Matheus3007/pcb-lab/boards/README.md

# Boards

| Board | Purpose | Status |
|---|---|---|
| `_template` | starting point, copy it | n/a |
| `pipeline-demo` | Phase 0 reference board: proves the pipeline end to end | done: all gates passed, JLC preview verified (not ordered) |
| `rebot-esc` | Rebot plug-in AM32 drive-ESC module (see docs/projects/battlebot.md) | parked after gate 2 (not approved): replaced by an off-the-shelf 4-in-1 |
| `rebot-ctrl` | Rebot mini controller: STM32G431 + IMU, CRSF in, DShot to a 4-in-1 ESC (see docs/projects/battlebot.md) | gate 3 packet + fab files ready (30 × 28 mm), not ordered |
| `rebot-ctrl-v2` | Smaller rebot-ctrl: STM32G431 in UFQFPN-32, signals on F + In2 between GND planes (25 × 25 mm) | gate 3 packet + fab files ready, not ordered |
