Matheus3007/pcb-lab/boards/rebot-ctrl/build/reports/summary.md

# rebot-ctrl — checks PASS

0 errors · 0 warnings · 47 waived  
board 30.05 × 28.05 mm · 58 footprints · 519 track segments · 118 vias · 605.28 mm copper

## circuit
- ✓ `circuit/assertion` Buck Vin: spike budget vs LMR36506 65 V: 40 V in [0, 58.5]
- ✓ `circuit/assertion` Buck output (RFBT 100k / RFBB 22k): 5.545 V in [5.3, 5.8]
- ✓ `circuit/assertion` +5V rail after the OR diode (receiver supply): 5.195 V in [4.75, 5.5]
- ✓ `circuit/assertion` +5V vs XC6206 6.0 V max input: 5.545 V in [0, 6]
- ✓ `circuit/assertion` XC6206 headroom (dropout ~0.25 V @ 100 mA): 1.895 V in [0.4, 3]
- … 7 more `circuit/assertionok`

## schematic
- ✓ `schematic/pins_match` all 209 symbol pins match parts.yaml
- ✓ `schematic/netlist_match` KiCad's netlist of the schematic equals circuit.py (43 nets)

## erc
- ! `erc/pin_to_pin` Pins of type Bidirectional and Power output are connected: Symbol U4 Pin 2 [SDX, Bidirectional, Line]; Symbol #FLG02 Pin 1 [Power output, Line] _(waived: LSM6DSV32X DS13511 table 2: SDx must be tied to VDD_IO or GND when the analog hub/Qvar is unused; tied to GND)_
- ! `erc/pin_to_pin` Pins of type Bidirectional and Power output are connected: Symbol U5 Pin 3 [~{WP}/IO_{2}, Bidirectional, Line]; Symbol U3 Pin 2 [VO, Power output, Line] _(waived: W25Q128JV: /WP tied high for standard (non-quad) SPI, as the datasheet requires; IO2 is never driven)_
- ! `erc/pin_to_pin` Pins of type Bidirectional and Power output are connected: Symbol U5 Pin 7 [~{HOLD}/~{RESET}/IO_{3}, Bidirectional, Line]; Symbol U3 Pin 2 [VO, Power output, Line] _(waived: W25Q128JV: /HOLD tied high for standard (non-quad) SPI, as the datasheet requires; IO3 is never driven)_

## drc
- ! `drc/silk_edge_clearance` Silkscreen clipped by board edge (board setup constraints silk clearance 0.1500 mm; actual 0.0000 mm): Polygon on Edge.Cuts; Segment of J3 on F.Silkscreen _(waived: USB-C footprint silk outline intentionally reaches the board edge (connector overhang marker, as in pipeline-demo); clipped by fab)_
- ! `drc/silk_edge_clearance` Silkscreen clipped by board edge (board setup constraints silk clearance 0.1500 mm; actual 0.1400 mm): Polygon on Edge.Cuts; Segment of J3 on F.Silkscreen _(waived: USB-C footprint silk outline intentionally reaches the board edge (connector overhang marker, as in pipeline-demo); clipped by fab)_

## parity
- ✓ `parity/ok` board matches the schematic (KiCad schematic parity)

## placement
- ✓ `placement/near` C10 -> U1 pad 23: 3.87 mm (max 4.4) — MCU VDD (pin 23) decoupling
- ✓ `placement/near` C11 -> U1 pad 35: 2.11 mm (max 2.6) — MCU VDD (pin 35) decoupling
- ✓ `placement/near` C12 -> U1 pad 48: 1.58 mm (max 2.1) — MCU VDD (pin 48) decoupling
- ✓ `placement/near` C15 -> U1 pad 21: 2.82 mm (max 3.3) — VDDA HF decoupling
- ✓ `placement/near` C14 -> U1 pad 21: 1.78 mm (max 2.3) — VDDA bulk
- ✓ `placement/on_edge` J1 courtyard -0.18 mm from top edge — ESC cable plugs in from the top edge
- ✓ `placement/on_edge` J3 courtyard -0.52 mm from top edge — USB-C mouth at the top edge (reachable with the lid off)
- ✓ `placement/on_edge` J2 courtyard -0.17 mm from left edge — receiver cable comes from the robot left side
- … 18 more `placement/nearok`

## parts
- · `parts/tiers` 24 unique parts: basic 15, preferred 1, extended 8 (extended: C160407 SM08B-SRSS-TB(LF)(SN), C189895 SM04B-GHS-TB(LF)(SN), C165948 TYPE-C-31-M-12, C2870127 LMR36506RRPER, C167761 FNR3015S220MT, C529356 STM32G431CBU6, C22461202 LSM6DSV32XTR, C190862 W25Q128JVPIQ)

## current
- ✓ `current/width` GND: min track 0.3 mm vs 0.115 mm needed for 0.5 A (IPC-2221, ΔT 10 °C, 1.0 oz)
- ✓ `current/width` VBAT: min track 0.4 mm vs 0.115 mm needed for 0.5 A (IPC-2221, ΔT 10 °C, 1.0 oz)
- ✓ `current/width` +5V: min track 0.4 mm vs 0.115 mm needed for 0.5 A (IPC-2221, ΔT 10 °C, 1.0 oz)
- ✓ `current/width` VBUS: min track 0.4 mm vs 0.115 mm needed for 0.5 A (IPC-2221, ΔT 10 °C, 1.0 oz)
- ✓ `current/width` BUCK_SW: min track 0.24 mm vs 0.115 mm needed for 0.5 A (IPC-2221, ΔT 10 °C, 1.0 oz)
- … 2 more `current/widthok`

## routing
- ! `routing/jog` 3V3 on F.Cu: 0.74 mm sideways step at (10.24, 17.36) (board coords, +Y down); straighten it (REROUTE=1, placement, or a scripted track) _(waived: 3V3 distribution, DC and decoupled at every pin; sub-mm steps around the QFN pins and fan-out vias)_
- ! `routing/jog` 3V3 on F.Cu: 0.28 mm sideways step at (10.76, 16.84) (board coords, +Y down); straighten it (REROUTE=1, placement, or a scripted track) _(waived: 3V3 distribution, DC and decoupled at every pin; sub-mm steps around the QFN pins and fan-out vias)_
- ! `routing/jog` 3V3 on F.Cu: 0.35 mm sideways step at (18.77, 16.82) (board coords, +Y down); straighten it (REROUTE=1, placement, or a scripted track) _(waived: 3V3 distribution, DC and decoupled at every pin; sub-mm steps around the QFN pins and fan-out vias)_
- ! `routing/jog` BUCK_FB on F.Cu: 1.33 mm sideways step at (3.82, 22.10) (board coords, +Y down); straighten it (REROUTE=1, placement, or a scripted track) _(waived: buck feedback node leaves U2 pin 8 around the GND pad's top exit to the divider; short, low-impedance divider node, no switching current)_
- ! `routing/jog` BUCK_SW on F.Cu: 0.20 mm sideways step at (5.11, 25.66) (board coords, +Y down); straighten it (REROUTE=1, placement, or a scripted track) _(waived: 0.2 mm step where the SW node meets the bootstrap cap C3; adds no measurable loop area (SW trace is 2 mm long))_
- · `routing/stats` 320 bends total; per net: +5V 11, 3V3 51, BOOT0 13, BUCK_BOOT 3, BUCK_FB 7, BUCK_SW 14, BUCK_VCC 7, CC1 3, CC2 3, CRSF_IN 3, CRSF_OUT 3, CRSF_RX 4, CRSF_TX 8, CURR_ADC 9, DSHOT1 5, DSHOT2 3, DSHOT3 5, DSHOT4 7, ESC_CURR 1, ESC_TLM 1, FLASH_CS 3, GND 7, IMU_CS 13, IMU_INT1 7, LED 7, LED_A 1, M1 6, M2 2, M3 4, M4 1, NRST 12, SPI_MISO 9, SPI_MOSI 12, SPI_SCK 11, SWCLK 6, SWDIO 7, TLM_RX 5, USB_DM 5, USB_DP 5, V5_BUCK 7, VBAT 14, VBAT_ADC 12, VBUS 3
- … 37 more `routing/jogwarningw`

## layout
- · `layout/return_path` BOOT0: 0.28 mm of track has no GND under it on the reference layer (worst 0.28 mm on B.Cu over a gap in In2.Cu at (13.41, 18.26)); the return current detours around the gap (loop area, crosstalk)
- ✓ `layout/finger` no unstitched dead-end GND tongues longer than 8.0 mm
- ✓ `layout/loop` buck HF input loop (C2): 2.12 mm² enclosed by C2.1 → U2.4 → U2.9 → C2.2 (max 3.0 mm²)
- ✓ `layout/loop` buck HF input loop (C2): U2.9 and C2.2 (GND) are not joined by copper on F.Cu; nearest GND vias 1.20 / 0.67 mm from them (max 1.5 mm, so the return drops straight into the plane)
- ✓ `layout/loop` buck bulk input loop (C1): 3.86 mm² enclosed by C1.1 → U2.4 → U2.9 → C1.2 (max 6.0 mm²)
- ✓ `layout/pair` USB_DP/USB_DM: lengths 16.15/11.92 mm, skew 4.23 mm (max 5.0)
