Matheus3007/pcb-lab/boards/rebot-ctrl-v2/build/fab/rebot-ctrl-v2-bom.csv

Comment | Designator | Footprint | LCSC Part #
JST-SH 8P (ESC) | J1 | JST_SH_SM08B-SRSS-TB_1x08-1MP_P1.00mm_Horizontal | C160407
JST-GH 4P (receiver) | J2 | JST_GH_SM04B-GHS-TB_1x04-1MP_P1.25mm_Horizontal | C189895
100 | R1,R2,R9,R10,R11,R12 | R_0402_1005Metric | C25076
USB-C 16P | J3 | USB_C_Receptacle_HRO_TYPE-C-31-M-12 | C165948
5.1k | R3,R4 | R_0402_1005Metric | C25905
B5819WS 40V 1A | D1,D2 | D_SOD-323 | C64886
LMR36506 buck | U2 | VQFN-HR-9_2x2mm_TI_RPE0009A | C2870127
22uH 3015 | L1 | L_Changjiang_FNR3015S | C167761
2.2uF | C1 | C_0805_2012Metric | C377773
100nF | C2,C3,C10,C11,C15,C16,C17,C18,C19,C20,C21 | C_0402_1005Metric | C307331
1uF | C4,C7,C8,C14 | C_0402_1005Metric | C52923
22uF | C5 | C_0805_2012Metric | C45783
100k | R5,R13,R15 | R_0402_1005Metric | C25741
22k | R6 | R_0402_1005Metric | C25768
XC6206 3.3V | U3 | SOT-23-3 | C5446
4.7uF | C6,C9,C13 | C_0402_1005Metric | C23733
STM32G431KBU6 | U1 | UFQFPN-32-1EP_5x5mm_P0.5mm_EP3.5x3.5mm | C529358
10k | R7,R14,R16,R18,R19 | R_0402_1005Metric | C25744
1k | R8,R17 | R_0402_1005Metric | C11702
red | D3 | LED_0603_1608Metric | C2286
LSM6DSV32X | U4 | LGA-14_3x2.5mm_P0.5mm_LayoutBorder3x4y | C22461202
GD25Q128E 16MB | U5 | WSON-8-1EP_6x5mm_P1.27mm_EP3.4x4.3mm | C24733358
