Matheus3007/pcb-lab/boards/rebot-ctrl-v2/build/review/gate-3.md

# rebot-ctrl-v2: review gate 3
_generated 2026-10-25 23:35 · checks PASS_

## Renders
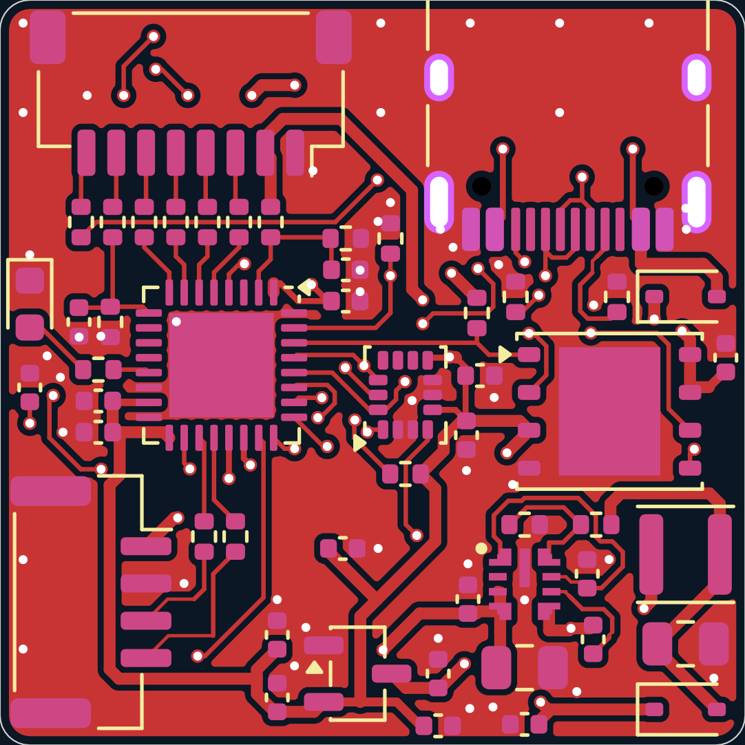
[picture p1: boards/rebot-ctrl-v2/build/renders/top.png]
top

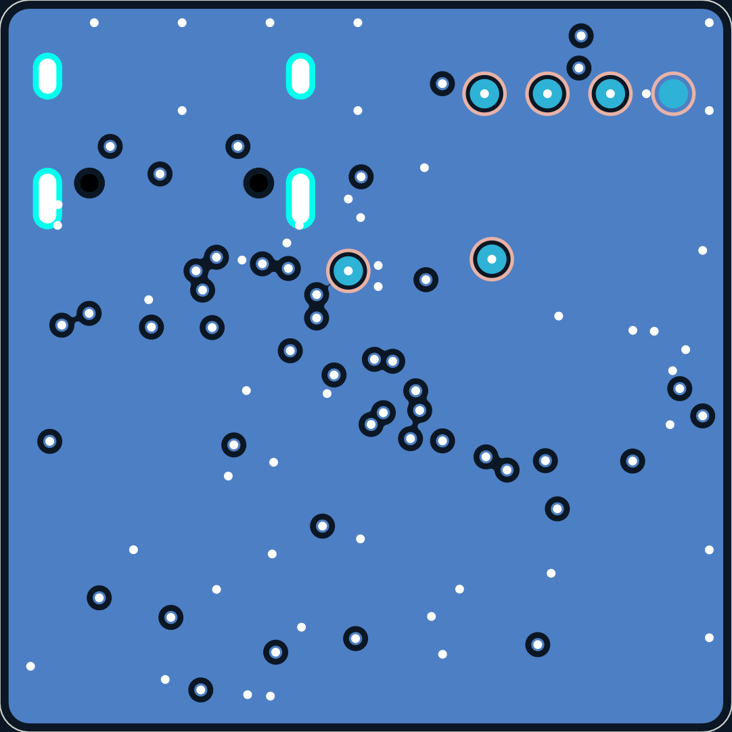
[picture p2: boards/rebot-ctrl-v2/build/renders/bottom.png]
bottom

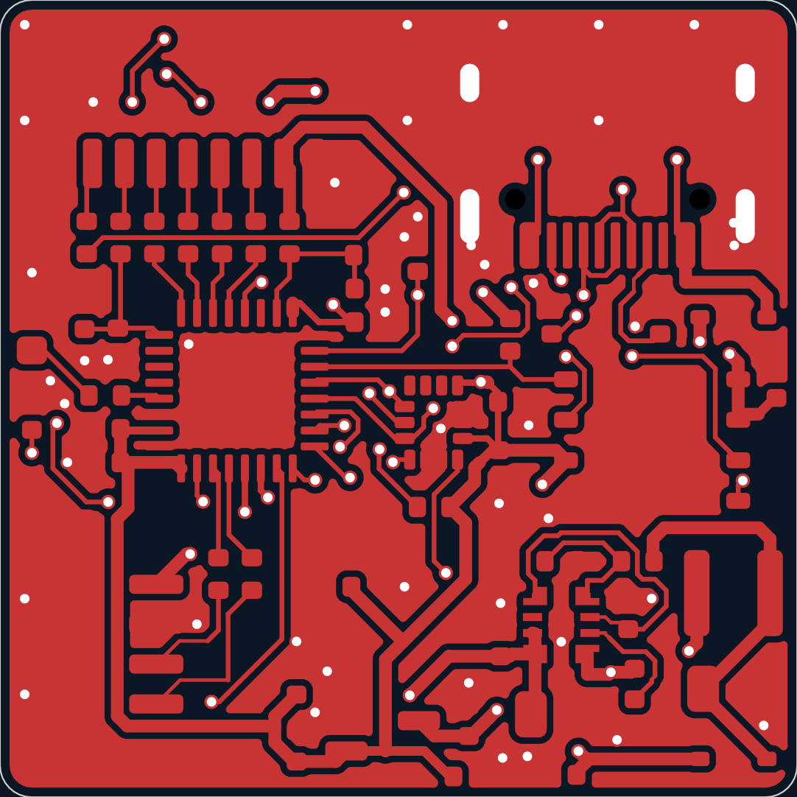
[picture p3: boards/rebot-ctrl-v2/build/renders/copper_top.png]
copper top

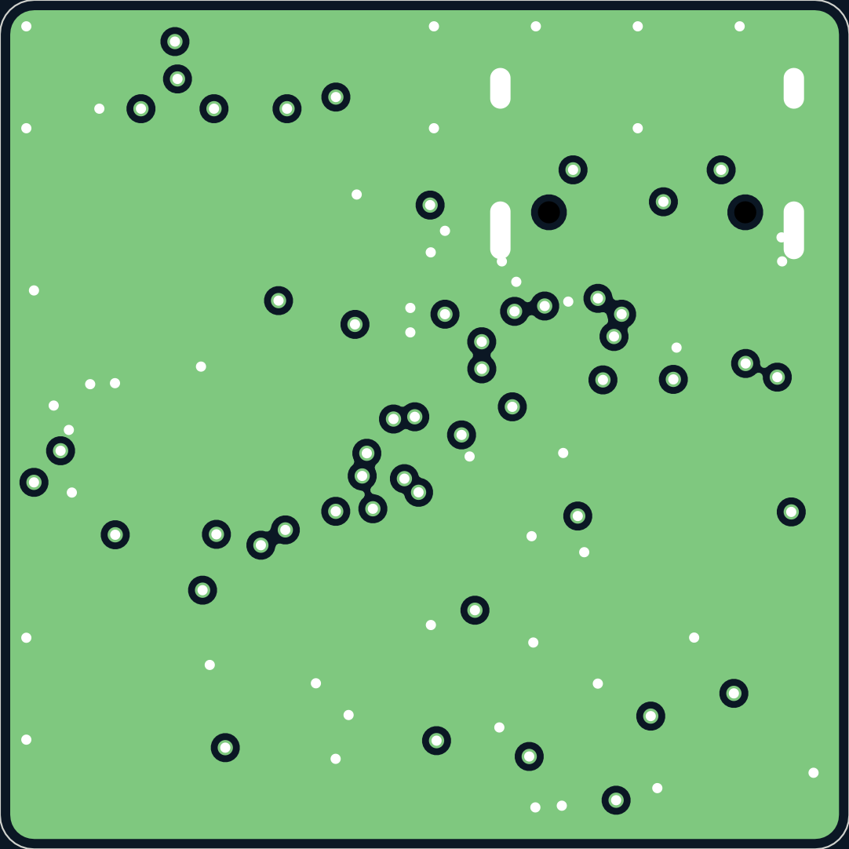
[picture p4: boards/rebot-ctrl-v2/build/renders/copper_in1.png]
copper in1

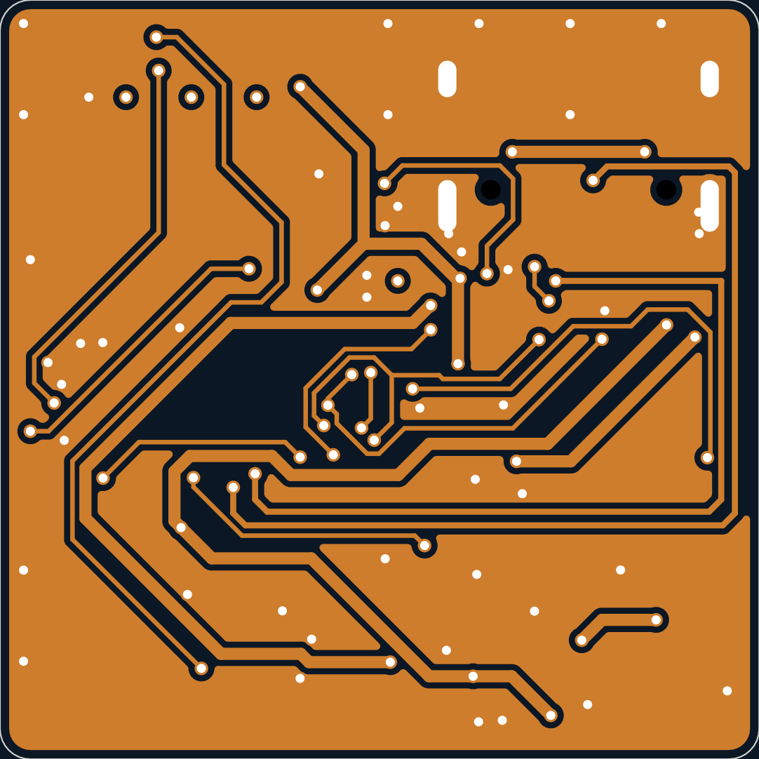
[picture p5: boards/rebot-ctrl-v2/build/renders/copper_in2.png]
copper in2

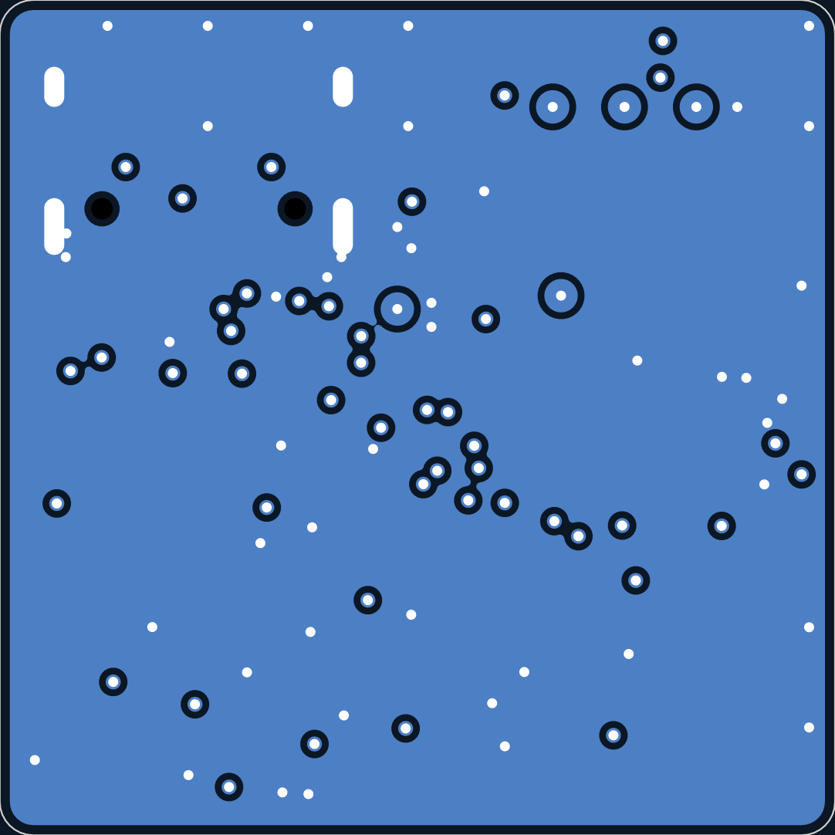
[picture p6: boards/rebot-ctrl-v2/build/renders/copper_bottom.png]
copper bottom

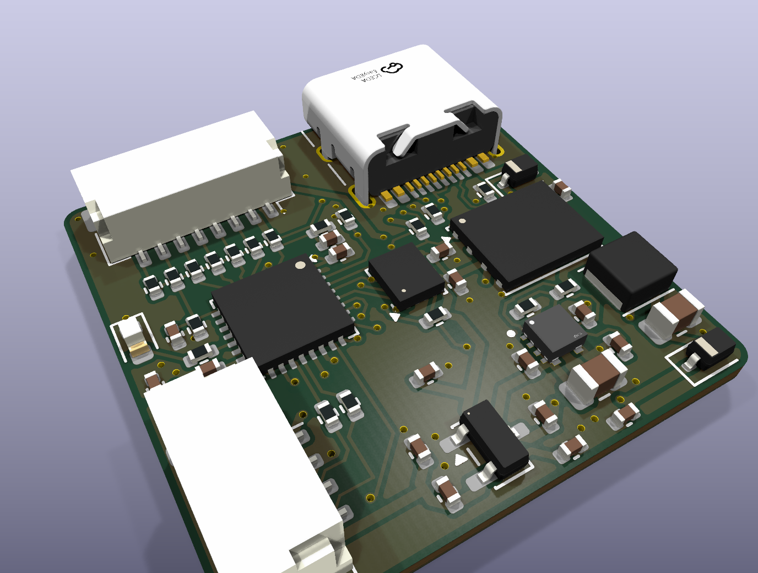
[picture p7: boards/rebot-ctrl-v2/build/renders/3d_iso.png]
3d iso


## Fab files (build/fab/)
- cpl_corrections.json
- rebot-ctrl-v2-bom.csv
- rebot-ctrl-v2-cpl.csv
- rebot-ctrl-v2-gerbers.zip
- rebot-ctrl-v2.kicad_pcb

## CPL rotation corrections applied (UNVERIFIED until you check JLC's preview)
- J2 `JST_GH_SM04B-GHS-TB_1x04-1MP_P1.25mm_Horizontal`: +0° (rule `^JST_GH_SM`, confirmed)
- J3 `USB_C_Receptacle_HRO_TYPE-C-31-M-12`: +0° (rule `^USB_C_Receptacle_HRO_TYPE-C-31-M-12`, confirmed)
- U1 `UFQFPN-32-1EP_5x5mm_P0.5mm_EP3.5x3.5mm`: -90° (rule `^UFQFPN-32-1EP_5x5mm`, confirmed)
- U3 `SOT-23-3`: +180° (rule `^SOT-23`, confirmed)
- U5 `WSON-8-1EP_6x5mm_P1.27mm_EP3.4x4.3mm`: +0° (rule `lcsc:C24733358`, confirmed)

Parts cost per board ≈ $18.46 + extended-part fees (8 unique extended)

## Before paying
1. Upload the gerber zip; inspect JLC's Gerber viewer (outline, cutouts, drills).
2. Upload BOM + CPL; check EVERY part's rotation/polarity in JLC's placement preview.
3. Record corrections in lib/jlc_rotations.csv (top of file), rebuild, re-upload.
4. After ordering: `git tag <board>/vX.Y` and note the order number in spec.md.
