Matheus3007/pcb-lab/boards/rebot-ctrl-v2/build/fab/rebot-ctrl-v2.kicad_pcb

## KiCad design boards/rebot-ctrl-v2/build/fab/rebot-ctrl-v2.kicad_pcb (2026-10-26)

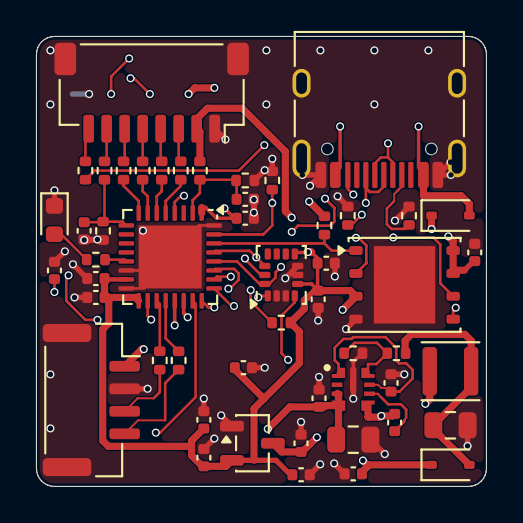
[picture p25: board rebot-ctrl-v2.kicad_pcb from above]

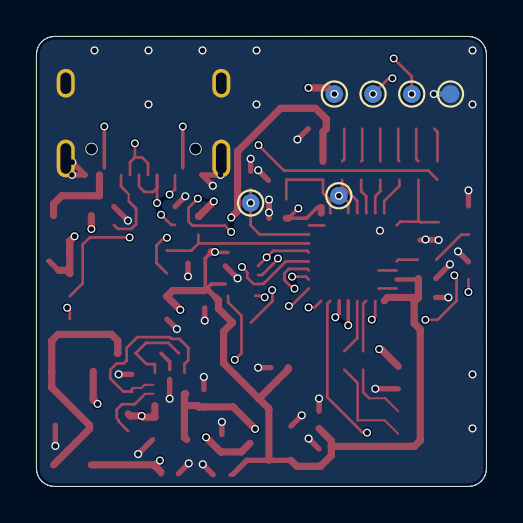
[picture p26: board rebot-ctrl-v2.kicad_pcb from below]

Board: 4 copper layers, 25.0 x 25.0 mm, 57 parts (6 on the bottom side), 43 nets.

Parts:
C1: 2.2uF; C_0805_2012Metric
C2, C3, C10, C11, C15, C16, C17, C18, C19, C20, C21: 100nF; C_0402_1005Metric
C4, C7, C8, C14: 1uF; C_0402_1005Metric
C5: 22uF; C_0805_2012Metric
C6, C9, C13: 4.7uF; C_0402_1005Metric
D1, D2: B5819WS 40V 1A; D_SOD-323
D3: red; LED_0603_1608Metric
J1: JST-SH 8P (ESC); JST_SH_SM08B-SRSS-TB_1x08-1MP_P1.00mm_Horizontal
J2: JST-GH 4P (receiver); JST_GH_SM04B-GHS-TB_1x04-1MP_P1.25mm_Horizontal
J3: USB-C 16P; USB_C_Receptacle_HRO_TYPE-C-31-M-12
L1: 22uH 3015; L_Changjiang_FNR3015S
R1, R2, R9, R10, R11, R12: 100; R_0402_1005Metric
R3, R4: 5.1k; R_0402_1005Metric
R5, R13, R15: 100k; R_0402_1005Metric
R6: 22k; R_0402_1005Metric
R7, R14, R16, R18, R19: 10k; R_0402_1005Metric
R8, R17: 1k; R_0402_1005Metric
TP1, TP2, TP3, TP4, TP5, TP6: pad; TestPoint_Pad_D1.0mm
U1: STM32G431KBU6; UFQFPN-32-1EP_5x5mm_P0.5mm_EP3.5x3.5mm
U2: LMR36506 buck; VQFN-HR-9_2x2mm_TI_RPE0009A
U3: XC6206 3.3V; SOT-23-3
U4: LSM6DSV32X; LGA-14_3x2.5mm_P0.5mm_LayoutBorder3x4y
U5: GD25Q128E 16MB; WSON-8-1EP_6x5mm_P1.27mm_EP3.4x4.3mm

Connections:
3V3: C8.1, C9.1, C10.1, C11.1, C13.1, C14.1, C15.1, C19.1, C20.1, C21.1, R18.2, R19.2, TP1.1, U1.1, U1.15, U1.17, U3.2, U4.5, U4.8, U5.3, U5.7, U5.8
+5V: C6.1, C7.1, D1.1, D2.1, J2.1, U3.3
BOOT0: R7.1, TP6.1, U1.31
BUCK_BOOT: C3.1, U2.6
BUCK_FB: R5.2, R6.1, U2.8
BUCK_SW: C3.2, L1.1, U2.5
BUCK_VCC: C4.1, U2.1, U2.7
CC1: J3.A5, R3.1
CC2: J3.B5, R4.1
CRSF_IN: J2.3, R1.1
CRSF_OUT: J2.4, R2.1
CRSF_RX: R1.2, U1.19
CRSF_TX: R2.2, U1.20
CURR_ADC: C17.1, R13.2, R14.1, U1.9
DSHOT1: R9.2, U1.5
DSHOT2: R10.2, U1.6
DSHOT3: R11.2, U1.7
DSHOT4: R12.2, U1.8
ESC_CURR: J1.7, R13.1
ESC_TLM: J1.8, R17.1
FLASH_CS: R19.1, U1.30, U5.1
GND: C1.2, C2.2, C4.2, C5.2, C6.2, C7.2, C8.2, C9.2, C10.2, C11.2, C13.2, C14.2, C15.2, C16.2, C17.2, C18.2, C19.2, C20.2, C21.2, D3.1, J1.1, J1.MP, J2.2, J2.MP, J3.A1, J3.A12, J3.B1, J3.B12, J3.SH, R3.2, R4.2, R6.2, R7.2, R14.2, R16.2, TP2.1, U1.14, U1.16, U1.32, U1.33, U2.9, U3.1, U4.2, U4.3, U4.6, U4.7, U5.4, U5.9
IMU_CS: R18.1, U1.29, U4.12
IMU_INT1: U1.18, U4.4
LED: R8.1, U1.13
LED_A: D3.2, R8.2
M1: J1.3, R9.1
M2: J1.4, R10.1
M3: J1.5, R11.1
M4: J1.6, R12.1
NRST: C16.1, TP5.1, U1.4
SPI_MISO: U1.27, U4.1, U5.2
SPI_MOSI: U1.28, U4.14, U5.5
SPI_SCK: U1.26, U4.13, U5.6
SWCLK: TP4.1, U1.24
SWDIO: TP3.1, U1.23
TLM_RX: R17.2, U1.25
USB_DM: J3.A7, J3.B7, U1.21
USB_DP: J3.A6, J3.B6, U1.22
V5_BUCK: C5.1, D1.2, L1.2, R5.1
VBAT: C1.1, C2.1, J1.2, R15.1, U2.3, U2.4
VBAT_ADC: C18.1, R15.2, R16.1, U1.2
VBUS: D2.2, J3.A4, J3.A9, J3.B4, J3.B9
