Matheus3007/pcb-lab/(commit log)

2026-10-11 Scaffold pcb-lab: code-first PCB pipeline docs, board template, toolchain decision
2026-10-11 Phase 0: working code-first PCB pipeline + pipeline-demo board
    Replace atopile (CLI end-of-life, part picking now needs sign-in, APIs down) with
    plain-Python circuits (decision 0002). Pipeline: circuit.py -> pcbnew board
    generation -> Freerouting -> GND stitching -> DRC + custom checks -> renders ->
    JLC gerbers/BOM/CPL, review dashboard + gate packets, semantic diff.
    pipeline-demo passes all checks (0 errors, 0 warnings, 2 waived).
2026-10-11 Deterministic builds: route lock for Freerouting, sorted board dump
    Freerouting is not deterministic (unseeded randomness even single-threaded), so its
    SES output is committed as route.lock.ses keyed by a canonical fingerprint of the DSN
    input. Same sources now produce a byte-identical board.json; REROUTE=1 forces a new
    route. Also disables Freerouting analytics.
2026-10-11 Write LF line endings from KiCad-side jobs
2026-10-11 Agent knowledge: hard-won lessons in CLAUDE.md, 5 project skills, part/footprint research commands
    - CLAUDE.md: environment, tooling, data-source and geometry lessons from Phase 0
    - .claude/skills: new-board, add-part, board-iteration (with DRC playbook), review-gate, jlc-order
    - make part LCSC=...: JLC data, datasheet via JLC file endpoint, pin-table pages as text+PNG,
    KiCad footprint candidates
    - make footprint FP=...: pad table, body/courtyard extents, facing hint, 3D model check, PNG
    - lib/basic_passives.yaml: catalog-verified JLC Basic passives
2026-10-11 Add make open: view a generated board in KiCad's PCB editor
2026-10-11 KiCad 10.0.7: version-independent route-lock fingerprint, solid shield-pad pour connection
    KiCad auto-updated 10.0.5 -> 10.0.7; the DSN parser header (host_version) was part of the
    route-lock fingerprint, forcing a reroute that exposed starved thermals on the USB-C
    shield pads. Fingerprint now ignores the parser header; parts.yaml can set per-pad
    zone_connection (USB-C SH pads: full). pipeline-demo rerouted once and passes again.
2026-10-11 JLC preview fixes: shared bottom-left origin, no drill maps, confirmed rotation table
    From the first JLC preview of pipeline-demo:
    - gerbers/drill used page-absolute coords while the CPL used the aux origin -> 'component may
    be offset' prompt. All three now use the aux origin at the outline's bottom-left.
    - drill maps were shipped in the zip and showed up as an extra layer; removed.
    - community rotation hints were wrong for HRO TYPE-C-31-M-12 (+180 put the leads at the edge)
    and SOT-23 (-90 put legs off the pads). New lib/jlc_rotations_confirmed.csv takes precedence.
2026-10-11 JLC CPL: 1.575 mm origin offset for HRO TYPE-C-31-M-12 (preview 2 showed overhang)
2026-10-11 JLC CPL: confirm HRO USB-C offset; SOT-23 needs 180 deg (preview showed pin 1 diagonally opposite)
2026-10-11 Routing quality: no unneeded bends
    - routeq: jog detector + bend stats; routing/jog check (warning) and routing/stats
    - best-of-N autorouting with seeded DSN permutations (reproducible variety) scored on
    jogs, vias, bends and length; all attempts recorded in route.lock.json
    - kijobs/straighten.py: cuts jogs like KiCad's optimizer, clearance-checked
    - parts/extended check: plain Extended parts need extended_reason
    - CLAUDE.md + skills: no-unneeded-bends rule, Basic > Preferred > Extended priority,
    corrected Freerouting determinism lesson
    pipeline-demo rerouted: 0 jogs (was 6), 28 bends (was 40), 75 mm copper (was 102 mm), no
    loop around J1. Checks PASS.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
2026-10-11 Generated KiCad schematic from circuit.py: ERC, pin cross-check, parity, editable layout
    circuit.py stays the only source of connectivity. Every build now also writes a one-sheet
    KiCad 10 schematic (stock symbols, global net label on every pin, NC flags, parts framed by
    `with c.block(...)`, PWR_FLAGs from `c.power_flag(...)`) and checks it four ways:
    - schematic/pin_name: KiCad symbol pin names vs parts.yaml names per pad (catches clone pinouts)
    - schematic/netlist_match: KiCad's own netlist of the drawing == circuit.py, pad for pad
    - erc/*: KiCad ERC with pin electrical types
    - parity/*: DRC --schematic-parity, board == schematic
    Layout is human-editable: move things in KiCad (make sch-ope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
2026-10-11 battlebot: record Rebot facts, v1/v2 scope and rear-wall board location
    Robot specs (6S LiHV 26.1 V, wye-wound motors, 64 g electronics budget), the RX
    brownout hypothesis (BEC rated 7-26 V), connector and pigtail rules, v1 = controller +
    onboard drive ESCs with v2 weapon ESC, R$600 per order, and the board location measured
    from RebotAssemblyV3.STEP: ~78x30 mm standing against the inner rear wall.
2026-10-11 battlebot: carrier board + plug-in AM32 drive-ESC modules
    All wiring ends on a vertical carrier; drive ESCs are screw-retained plug-in modules
    (~15x22 mm) so a dead ESC swaps in about a minute without soldering. Modules sized
    for 20-30 A peak phase current, since the measured 2.5 A drive draw is battery-side.
2026-10-11 battlebot: drive-ESC module research, OpenESC-20x20 as reference
    Stock AM32 target OPENESC_20_F421 (AT32F421 + NSG2065Q) runs unmodified if the pin
    mapping is kept; MOSFETs move from 30 V to 60 V for 6S LiHV. Candidate JLC parts,
    CERN-OHL-S licence note, and the open header-current question.
2026-10-11 battlebot: ESC module part deep dive (DRV8300D, 60 V HSBB6066, screw-joint phases)
    JLC Basic/Preferred have no usable power FET, gate driver or AM32 MCU, so the core is
    Extended, ranked by stock and specs. Keep AT32F421 (stock firmware), switch to TI
    DRV8300D fed 12 V from the carrier, 60 V HSBB6066 FETs, phases on 3 M2 screws into
    JLC-placed SMD standoffs, modules mounted 180 deg apart facing their motors.
2026-10-11 battlebot: mount ESC standoffs on the carrier's back so screws compress, not peel
2026-10-11 battlebot: correct standoff load analysis; pogo pins for module signals
    Front-mounted SMD standoffs don't carry screw preload (the clamp loop closes in
    screw-module-standoff), so the back-mount change was unnecessary. The 2-3 mm gap
    fits SMD pogo pins for battery, GND, 12 V and DShot.
    Claude-Session: https://claude.ai/code/session_017ebHtPabZrHkJ3hGnLnJVi
2026-10-11 battlebot: lock carrier MCU STM32G431CBT6 and IMU LSM6DSV32X
    Same STM32G4 family and ST IMU family as the Team-Micras micromouse, so their
    firmware packages, comm link and HM-19 BLE setup can be reused.
    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
2026-10-11 battlebot: ESC modules plug in through one 2x9 header, screw or tape retention
    Drops the screw-joint phases and pogo pins as too many failure points for v1.
    18 through-hole pins (3 per phase, 3 battery, 4 GND, 12 V, DShot); one M2 screw
    preferred, tape alone must also work. Modules move to the deep ends of the channel.
    Restores the placement note lost in an earlier edit.
    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
2026-10-11 rebot-esc: scaffold drive-ESC module board and spec draft
    AM32 module (AT32F421 + DRV8300D + 6x HSBB6066) on a 2x9 header, ~25x15 mm,
    4-layer 1.0 mm, Economic one-sided, 10 pcs. Open questions listed in spec.md.
    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
2026-10-11 rebot-esc: spec answers (hand-soldered header, 1 oz, black ENIG)
    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
2026-10-11 rebot-esc: SWD on a 2x10 header; per-motor current sensing moves to the carrier
    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
2026-10-11 rebot-esc: gate-1 circuit (AT32F421 + DRV8300D + 6x HSBB6066), keyed 2x10 header
    Circuit, parts with datasheet pinout evidence, own PRPAK3x3 footprint and AT32F421/
    DRV8300 symbols. 10 design assertions pass, ERC 0, 177 symbol pins match parts.yaml.
    Header keyed at pin 7: a 180-degree plug-in would short the battery through body diodes.
    Pipeline: write fp-lib-table for repo-local footprint libraries so ERC resolves them.
    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
2026-10-11 rebot-esc: gate 1 packet; gate-1 packets skip pre-placement layout findings
    Gate 1 comes before outline and placement, so DRC/placement/current/model findings
    (here ~2000 from parts stacked at the origin) are left to gate 2 instead of burying
    the parts and pinout review. Layout reports from the placeholder build are not committed.
    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
2026-10-11 rebot-esc: gate 1 review notes; size power copper for 5 A continuous
    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
2026-10-11 rebot-esc: self-contained power (LMR36506 65 V buck -> 11 V gate rail)
    The module now takes only battery + DShot like an off-the-shelf ESC; the carrier's
    12 V rail is gone and header pin 8 is a 4th GND. Buck: TI LMR36506 (2x2 mm, 1 MHz,
    22 uH FNR3015S), footprint checked against TI's land pattern. 13 assertions pass,
    ERC 0, 202 symbol pins match. Gate-1 packet regenerated.
    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
2026-10-11 rebot-esc: gate 1 approved
    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
2026-10-11 pipeline: net classes from circuit.py actually reach the board; model check gaps
    - stage_board deletes the previous .kicad_pro: NewBoard() loaded it and SaveBoard kept its
    stale net classes (rebot-esc kept Default 0.2 mm and a removed 12V pattern)
    - build_board stores the edited default class with SetDefaultNetclass
    - stage_schematic writes a minimal .kicad_pro so ERC finds the lib tables on a fresh board
    - models check: also flag footprints with no 3D model; parts.yaml may reference stock models
    - gate-2 packets leave unrouted connections to gate 3
    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
2026-10-11 rebot-esc: gate 2 outline + placement (34 x 21 mm)
    Header along the bottom edge (bottom side, keyed pin 7), three vertical half bridges over
    their phase pins, VBAT bulk over each high-side drain, BEMF dividers under the low-side
    FETs, MCU/driver/buck/LDO on the left. 26 placement rules pass; DRC clean apart from
    unrouted nets (gate 3, autoroute off). Default net class 0.125 mm for the 0.4 mm-pitch MCU,
    Power class 0.15 mm. 3D models for the driver (stock RGE body), MOSFETs and buck (EasyEDA,
    fetched by third_party.sh). Module ~3 g.
    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
2026-10-11 rebot-esc: motor pads on the module, short 2x5 carrier header
    Like an off-the-shelf ESC: the three phases go to SMD solder pads (with vias) for the motor
    wires, under each half-bridge column; only battery, GND, DShot and SWD go to the carrier
    through a keyed 2x5 header (key at pin 7). Motor current no longer crosses header pins or
    the carrier. Same 34 x 21 mm outline, ~2.3 g. Gate 1 pre-approved by the owner for this
    change; gate-1 and gate-2 packets regenerated.
    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
2026-10-11 rebot-esc: ESC-style layout (36 x 20 mm), header left, motor pads right
    Owner's call, like a B-CUBE 45A: the keyed 2x5 header runs along the left short edge, the
    three motor pads stack on the right short edge, and each phase is a row in between (VBAT
    bulk -> HS FET -> LS FET -> pad), with its gate resistors, BEMF divider and HF cap in the
    gap above the row. MCU/driver/buck/LDO between header and power stage. 29 placement rules
    pass; DRC clean except unrouted nets (gate 3).
    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
2026-10-11 rebot-esc: lift the LMR36506 3D model 0.9 mm onto the board
    EasyEDA's STEP for C2870127 is modelled hanging below its origin (z -0.9..0), so the body
    sat inside the board and the pads poked through it in the renders (spotted by the owner).
    Footprint unchanged (matches TI's land pattern).
    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
2026-10-11 battlebot: off-the-shelf 4-in-1 + own mini controller (rebot-ctrl); park rebot-esc
    The bot is at the weight limit. Power goes to a Flywoo GOKU G45M 4-in-1 (6.4 g, AM32,
    fits standing in the rear channel); control to a tiny own board: STM32G431 + LSM6DSV32X,
    8-pin JST-SH to the ESC, 65 V buck powering the receiver over JST-GH, log flash, USB/SWD
    pads, HM-19 header, taped to the ESC. The custom ESC module is parked after gate 2.
    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
2026-10-11 battlebot: rebot-ctrl gets USB-C that doubles as the BLE dongle port
    Micras-style: D-/D+ wired to the G431's USB pins and, in parallel, to a spare USART
    (PA11/PA12 can't be a UART on the G4), 3.3 V on SBU for the HM-19 dongle, VBUS sensed to
    pick the mode. Replaces the USB pads and the separate BLE header.
    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
2026-10-11 rebot-ctrl: gates 1-2, mini controller circuit + placement (30 x 28 mm)
    STM32G431CBU6 + LSM6DSV32X + W25Q128JV on SPI1, CRSF on USART1, DShot x4 on TIM3,
    ESC current/VBAT on ADC (100k/10k so a reversed ESC cable is survivable), ESC
    telemetry on USART2. 65 V LMR36506 -> 5.55 V, Schottky-OR with USB VBUS, XC6206 3.3 V.
    JST-SH 8P ESC + USB-C on the top edge, JST-GH 4P receiver on the left, SWD/boot pads.
    12 assertions, ERC clean (datasheet tie-offs waived), 26 placement rules. Gates
    pre-approved by the owner.
    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
2026-10-11 USB-C (HRO TYPE-C-31-M-12) 3D model: offset -1.07 mm, not +1.575
    The model sat 2.65 mm too far into the board (spotted by the owner on rebot-ctrl, where it
    clipped D2). 1.575 mm is the JLC CPL origin offset; the 3D offset comes from slicing the
    STEP: after rot 180 its shell legs must land on the footprint's leg holes. Verified in
    pipeline-demo's 3d_iso: leads on their pads, legs in their holes. Renders updated.
    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
2026-10-12 routing: 45-degree only, protected plane layers, survive router timeouts
    - the jog straightener bridged jogs at arbitrary angles (the crooked traces the owner
    spotted); bridges are now exactly 45 degrees to the run (da + dc = sideways offset)
    - the router input gets (snap_angle fortyfive_degree) explicitly (Freerouting's output was
    already on-grid; this keeps it so), part of the lock fingerprint
    - routing.yaml autoroute.plane_layers marks layers (type power) so signals stay off a solid
    GND plane (rebot-ctrl had NRST/SWDIO routed through In1)
    - new routing/angle check + score penalty for segments off the 45-degree grid
    - a Freerouting attempt that times out no longer kills the build
    Co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
2026-10-12 pipeline: unrouted connections in the route score, island vias anywhere that clears other nets
    - dump.py reports totals.unrouted; routeq scores +500 per unrouted connection so best-of-N never
    picks an incomplete route; pipeline.py carries it into route results.
    - stitch.py: a GND island with no in-pour via spot falls back to any spot that collides with no
    other-net pad/track/via on any layer (KiCad collision shapes).
    - docs/jlcpcb.md: via-to-via hole spacing 0.2 mm, pad holes 0.45 mm.
    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
2026-10-12 rebot-ctrl: routed (4 layers, all nets, checks PASS)
    - Freerouting best of 4 (attempt 1: 21 jogs, 50 vias), locked in route.lock.*; 423 segments,
    84 vias incl. 28 grid + 6 island GND stitching vias, 545 mm copper.
    - FLASH_CS scripted: MCU pad 44 is boxed in by SPI_MOSI/IMU_INT1, every attempt failed it; fixed
    escape via In2 along y 18.3 to U5 pin 1.
    - Power net class vias 0.45/0.2 (was 0.45/0.3: annular ring + hole clearance errors); IMU INT2 NC.
    - In1.Cu solid GND plane (no routing), GND pours on F/In2/B, scripted GND for U2 EP and the
    R7/C13/C12 pads under the MCU.
    - 21 short pin-escape jogs + 1 sub-pad angle stub waived with reasons (all viewed in copper_top).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
2026-10-12 fab: export inner copper layers (4-layer boards shipped without In1/In2)
    GERBER_LAYERS listed only outer layers, so rebot-ctrl's zip had no In1.Cu/In2.Cu. Inner layers now
    come from board.yaml layers, and fab fails if the copper gerber count doesn't match.
    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
2026-10-12 checks: layout hygiene group (return paths, pour fingers, hot loops, diff pairs, via counts)
    New layout/* checks on the copper polygons that kijobs/copper.py exports after stitching:
    - return_path: signal track length with no GND on its reference layer (nearest plane: F<->In1,
    In2<->B on JLC 4-layer), own via clearance holes excluded; warn > 0.3 mm per net.
    - finger: dead-end GND pour tongues < 0.8 mm wide, > 3 mm long, with no via or pad.
    - loop: area of listed current loops + same-layer return or a GND via within 1.5 mm of each pad.
    - pair / vias: diff-pair skew, layers and vias alike; via limits on sensitive nets.
    Configured per board in routing.yaml layout:. Documented in docs/pipeline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
2026-10-12 pipeline: GND pad fan-out before routing, stale KiCad locks, sub-width angle stubs
    - build_board: routing.yaml fanout: gives every small SMD pad of a net its own short track + via (45-degree
    grid, KiCad collision check) before routing, so signal traces can't box GND pads into via-less pour islands.
    - stage_board deletes ~*.lck and fails if the .kicad_pro wasn't written (a killed run left a lock: the
    board then routed and DRC'd on KiCad default rules).
    - routing/angle ignores segments shorter than their own width (router snapping onto off-grid pad centres).
    - layout/finger default 8 mm (~lambda/20 at 1 GHz on FR4); layout/vias takes several net groups.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
2026-10-12 rebot-ctrl: F|GND|GND|B stackup, scripted USB pair, GND fan-out, IMU INT1 on PC13
    Layout checks drove this reroute:
    - layout/return_path: In2 and B.Cu both carried signals and cut each other's reference; In2 is now a
    second solid GND plane (signals on F/B only). Result: every signal track has unbroken GND under it.
    - layout/loop: buck input caps C1/C2 and U2's GND pad get their own GND vias (1.2/0.67/0.95 mm away);
    loop areas 2.1 mm^2 (HF) and 3.9 mm^2 (bulk).
    - USB D+/D- scripted on B.Cu as a 45-degree pair (router had made them 22 vs 2.6 mm); skew 4.2 mm, 2 vias each.
    - IMU_INT1 moved PB7 -> PC13 (pad 2 faces the IMU; PB7 was boxed in on two signal layers). Firmware: EXTI13.
    - GND fan-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
2026-10-12 pipeline-demo: reroute at 45 degrees (snap setting changed the lock), layout checks configured
    Reroute forced by the snap_angle fingerprint change: all copper at 0/45/90. layout/return_path exempts
    VBUS/3V3/CC1/CC2 on this 2-layer board (DC rails and static CC pull-downs, no fast edges).
    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
2026-10-13 battlebot: ESC and receiver sourcing notes (G45M doesn't ship to Brazil)
    HAKRC 32BIT 40A as the leading 4-in-1 candidate (31 x 30 mm, 6.1 g, BLHeli_32): same DShot/RPM/telemetry
    interface as AM32, but its 8-pin order is unpublished and the current scale needs a bench calibration.
    Alternatives rejected on size/mass are listed. Receiver: HappyModel EP2 TCXO (ceramic antenna) wired to J2.
    Not decided yet.
    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
2026-10-13 rebot-ctrl: commit the fab set (gerbers, BOM, CPL, board) for review on GitHub
    Generated at 2026-10-12 01:02 from the final route (57763bd): 4-layer gerber zip with In1/In2, BOM and CPL
    with rotation corrections, cpl_corrections.json, and the routed .kicad_pcb. build/fab/ stays ignored for the
    other boards; CLAUDE.md notes the exception and that the set must be regenerated with board changes.
    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
    [rebot-ctrl-bom.csv, rebot-ctrl.kicad_pcb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]
2026-10-13 render: inner copper layers for 4-layer boards
    copper_in1.png / copper_in2.png (seen from the top) are rendered when board.yaml has 4 layers, and the gate-3
    packet shows them: a board that routes signals on In2 (rebot-ctrl-v2) was otherwise invisible to review.
    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
2026-10-13 parts: STM32G431KBU6 (UFQFPN-32, C529358)
    Pinout from DS12589 Rev 2 fig. 5 / table 12 (UFQFPN32 column), exposed pad to ground per p.165; KiCad
    STM32G431KBUx symbol agrees pin for pin. Borrowed QFN-32 5x5 3D model.
    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
2026-10-13 rebot-ctrl-v2: 25 x 25 mm controller (v1 30 x 28), signals on F + In2 between GND planes
    Same circuit as rebot-ctrl; STM32G431 in UFQFPN-32, both ORing diodes B5819WS, SWD/boot pads on the bottom.
    Stackup F sig | In1 GND | In2 sig | B GND: each signal layer has a solid plane next to it and the face on the
    ESC is solid copper. Placement makes each MCU side face its peer: DShot/sense pins straight up into the ESC
    connector's resistor row, SPI to the IMU beside it and the flash beyond, UART/USB/SWD down. Scripted: DShot fan,
    USB pair (In2, round the right edge), VBUS bridge, FLASH_CS/BOOT0/NRST, IMU and VDD decoupling links.
    New pin map (firmware): DShot TIM2 PA0-3, CRSF USART1 with TX/RX swap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
    [rebot-ctrl-v2-bom.csv, rebot-ctrl-v2.kicad_pcb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]
2026-10-26 pipeline: hole_clearance rule; Standard PCBA rails are added by JLC
    - rules/jlc.yaml hole_clearance (0.25, KiCad's default, so no change for existing boards), applied by the builder;
    boards may go down to JLC's live 0.2 mm via-hole-to-track minimum with a reason
    - assembly/board_size is info, not an error, for Standard: JLC pads small boards to 71x71 with its own rails
    (live quote 2026-10-25, no panel fee), so no panelizer is needed
    - docs/jlcpcb.md + CLAUDE.md: via drill < 0.3 mm costs ~$51 on 5 boards (via option + Kelvin test + TG155),
    'Standard Only' parts force Standard PCBA
    Claude-Session: https://claude.ai/code/session_017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
    [jlc.yaml]
2026-10-26 parts: GD25Q128EWIGY (C24733358), STM32G431KBU3 stock fallback note
    GD25Q128E pinout from GigaDevice datasheet p.5 table 1 (same pads as the W25Q128JV), ordering code p.52,
    WSON8 6x5 package p.58 (EP 3.4 x 4.0, floating). JLC serves the PDF under C2982923 (same part on reel).
    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
2026-10-26 jlc rotations: UFQFPN-32 -90, JST-GH 0 (rebot-ctrl-v2 preview)
    Seen in JLC's 2D placement preview (tools/jlc run 20261025-212720): U1's pin-1 dot a quarter turn from the
    board's, J2's leads at the board edge with the community +180. Pending a re-check with the rules applied.
    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
2026-10-26 rebot-ctrl-v2: JLC cost cut, 0.3/0.45 vias, Standard PCBA, GD25Q128E flash
    Owner's cost cut (~$256 -> ~$188 for 5, measured on JLC's quote):
    - vias 0.2/0.45 -> 0.3/0.45 (JLC's no-surcharge option; drops the Kelvin test and TG155). Board rules:
    annular ring 0.075, hole clearance 0.2 (JLC live minimum), via hole-to-hole 0.25. Rerouted, best of 8.
    - lead-free HASL + green mask, Standard PCBA (the LSM6DSV32X is Standard-only; JLC adds the rails)
    - U5 W25Q128JVPIQ -> GD25Q128EWIGY (pin-compatible; firmware must accept JEDEC ID C8 40 18)
    - C17/C18 10 nF -> 100 nF: shares the 100 nF line, one BOM line fewer (CURR filter ~175 Hz)
    - CPL: U1 -90 and J2 0 from JLC's preview
    make diff: vias 102 -> 96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
    [rebot-ctrl-v2-bom.csv, rebot-ctrl-v2.kicad_pcb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]
2026-10-26 fab: CPL rotation rules keyed to an LCSC part; GD25Q128EWIGY at 0, U1/J2 confirmed
    JLC rotates by the part's EasyEDA model, which can differ between parts on one footprint: the GigaDevice
    C24733358 model is 90 deg from the Winbond C190862 one on the same WSON-8 6x5 footprint. A rule pattern
    'lcsc:C...' now matches the ref's LCSC part. U1 -90 and J2 0 confirmed in JLC's preview with the rules applied.
    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
2026-10-26 rebot-ctrl-v2: U5 CPL rotation 0 (GD25Q128E model), all CPL rotations confirmed
    JLC preview (tools/jlc run 20261025-233523): U1, J2, U3, U4, U5 confirmed. Quote $186.98 for 5
    (PCB $13.10 + Standard PCBA $173.88), was $256.40.
    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
    [rebot-ctrl-v2-cpl.csv]
